Mawr277/RoboScribe/docs/Images/GUI2.png

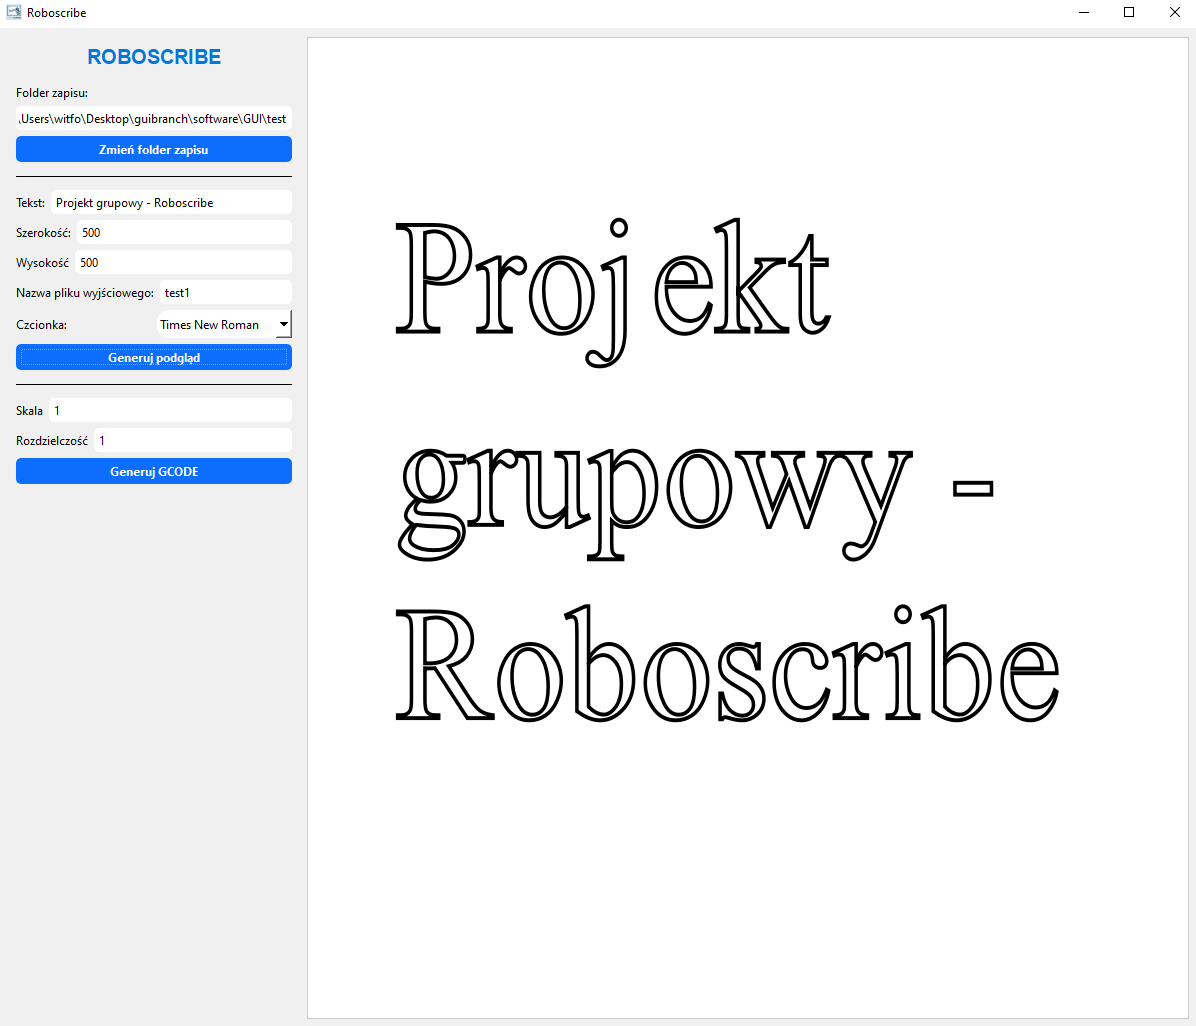
docs/Images/GUI2.png
