Mawr277/RoboScribe/docs/Images/GUI.png

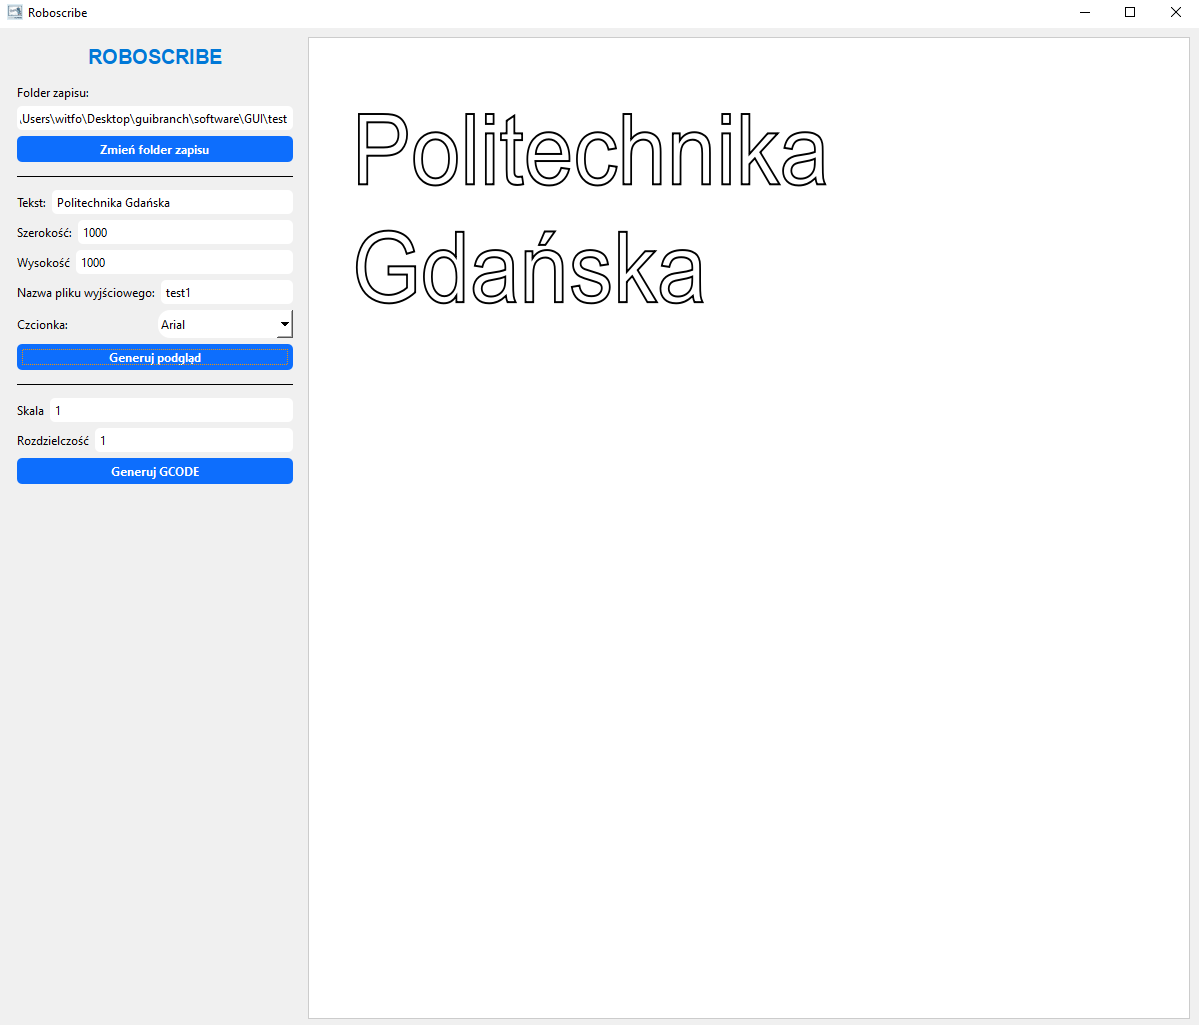
docs/Images/GUI.png
