Mawr277/RoboScribe/docs/Images/Schemat blokowy.png

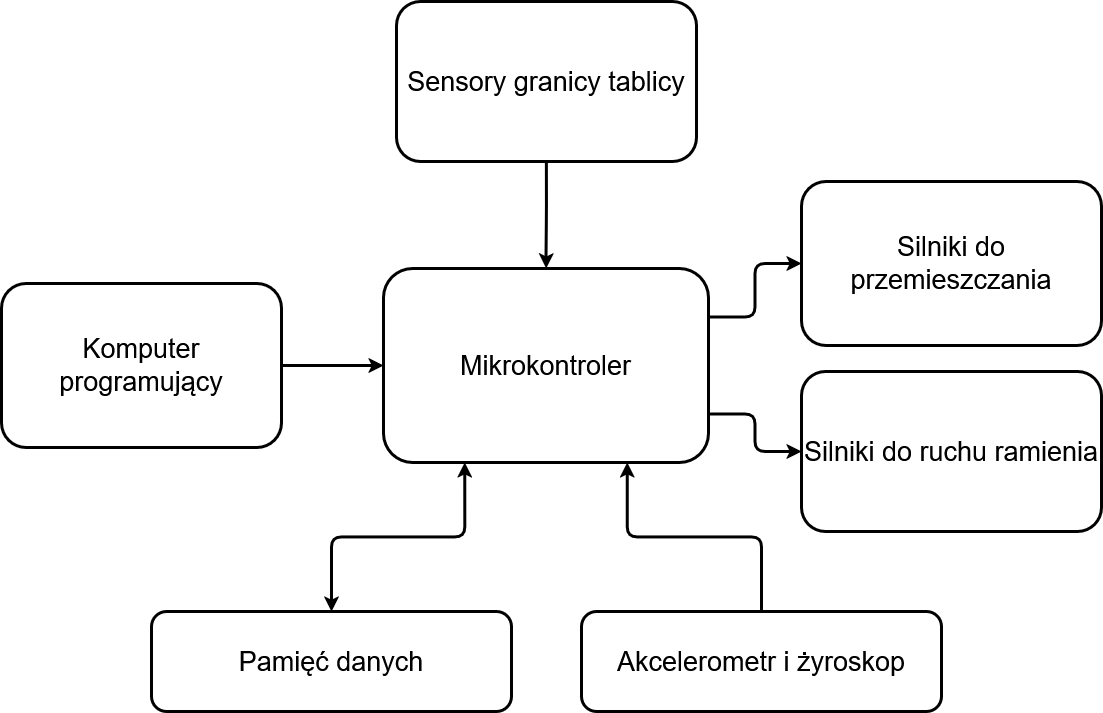
docs/Images/Schemat blokowy.png
