Mawr277/RoboScribe/docs/Images/Schemat funkcjonalny.png

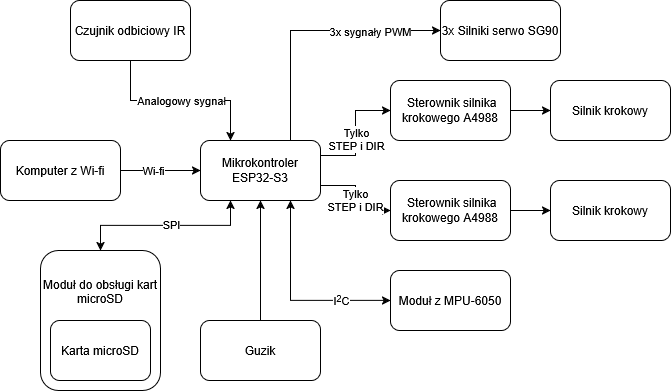
docs/Images/Schemat funkcjonalny.png
