Mawr277/RoboScribe/docs/Images/Zdjęcie modelu 3D.png

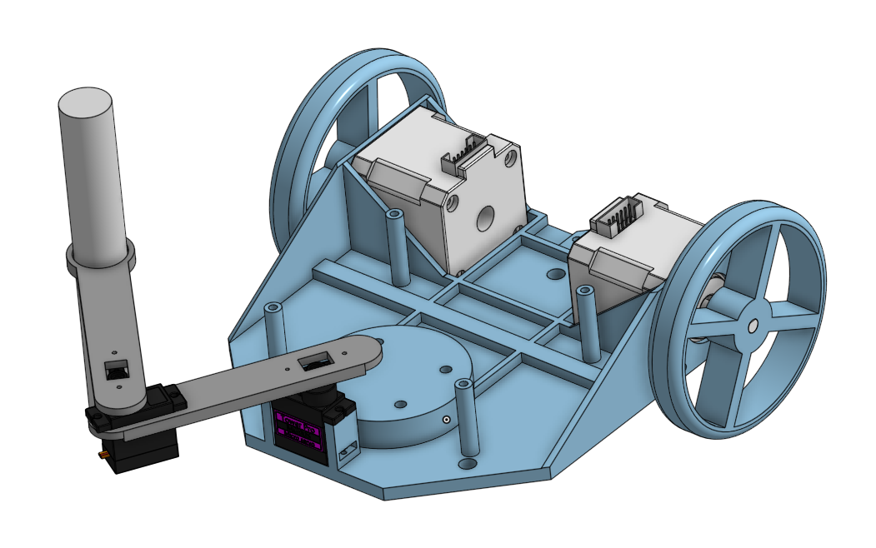
docs/Images/Zdjęcie modelu 3D.png
