Mawr277/RoboScribe/docs/circuit_schematic/schemat.kicad_pcb

## KiCad design Hardware/1_power.kicad_sch

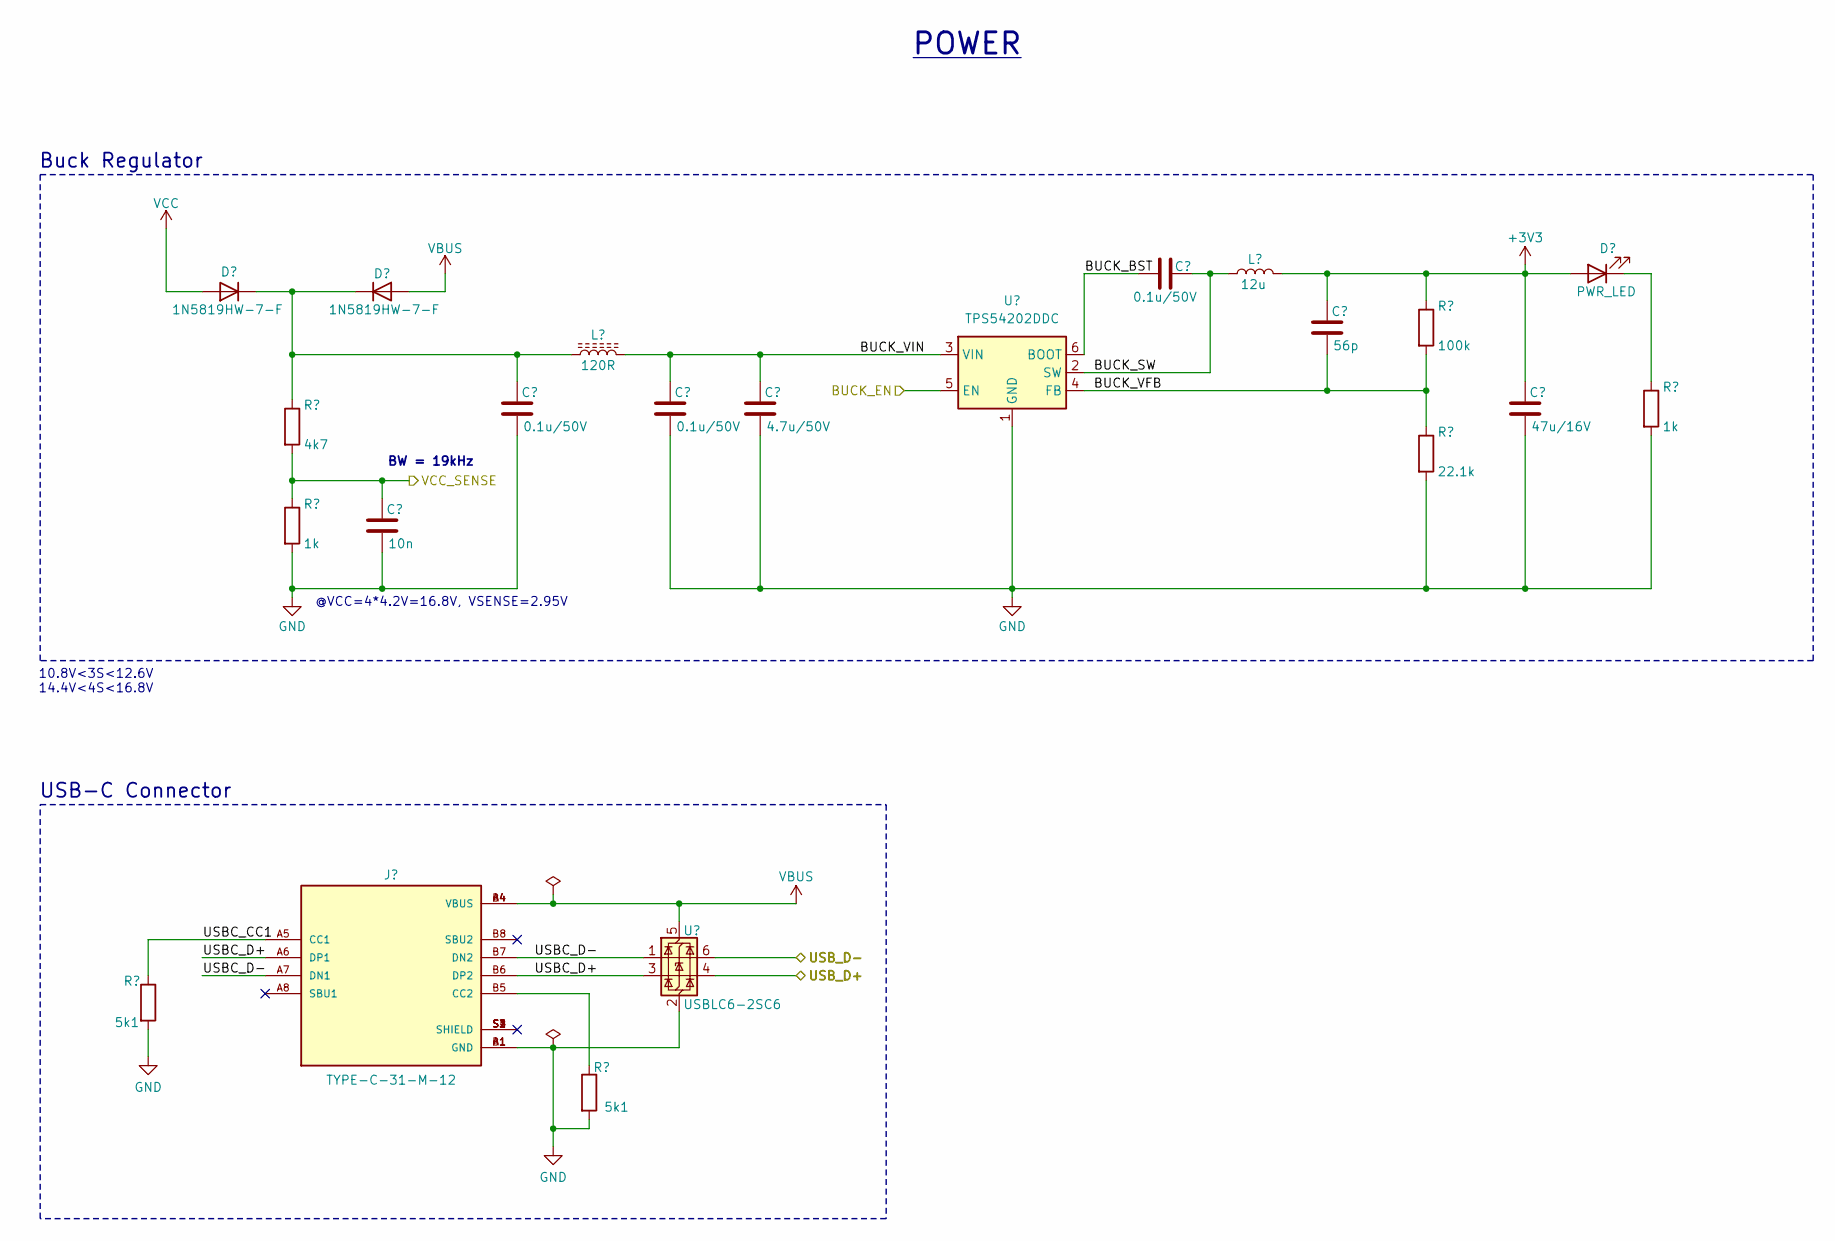
[picture p8: schematic 1_power.kicad_sch]

Parts:
J1: TYPE-C-31-M-12; HRO_TYPE-C-31-M-12; PARTREV 2020.12.08
U6: USBLC6-2SC6; SOT-23-6

Connections:
GND: J1.A1 (GND), J1.B1 (GND), U6.2 (GND)
unnamed: J1.S1 (SHIELD), J1.S2 (SHIELD), J1.S3 (SHIELD), J1.S4 (SHIELD)
USBC_CC1: J1.A5 (CC1)
USBC_D+: J1.A6 (DP1), J1.B6 (DP2), U6.3 (I/O2)
USBC_D-: J1.A7 (DN1), J1.B7 (DN2), U6.1 (I/O1)
USB_D+: U6.4 (I/O2)
USB_D-: U6.6 (I/O1)
VBUS: J1.A4 (VBUS), J1.B4 (VBUS), U6.5 (VBUS)

Notes on the sheet:
10.8V<3S<12.6V 14.4V<4S<16.8V
BW = 19kHz
USB-C Connector
POWER
@VCC=4*4.2V=16.8V, VSENSE=2.95V
Buck Regulator
