Mawr277/RoboScribe/(commit log)

2025-11-28 Adds MPU6050 drivers for communication and easy data acquisition
2025-11-28 Adds code for testing MPU6050 drivers functionality. Allows to check if chip is working properly
2025-12-29 Adds servo drivers for easier use
2025-12-29 Tests for servo drivers
2025-12-30 stworzenie plików
    [schemat.kicad_pcb, schemat.kicad_sch]
2025-12-30 wgranie diagramu połączeń
    [schemat.kicad_pcb, schemat.kicad_sch]
2025-12-31 przestawiony chemat
    [schemat.kicad_sch]
2026-01-04 Aktualna wersja schematu elektronicznego
    [schemat.kicad_sch]
2026-01-11 Add documentation for MPU6050 and servo drivers. Moves tests for drivers into their respective directories.
2026-01-12 Dodano rekursywne przetwarzanie grup elementów svg i prototypowa odwrotna kinematyka robota.
    Na tą chwile wszystkie ważne elementy svg są przetwarzane(poza Text ale to wynika głównie z ograniczeń biblioteki i trochę z samego formatu svg)
    Teoretycznie kod generuje gcode z kątami dla serwo ( komenta M1 T1= kąt dla pierszego T2 = kąt dla drugiego) oraz punkt dla bazy robota ale wymaga testów.
2026-01-14 working text to SVG generation
    added second button but SVG to GCODE function have hardcoded paths. Waiting for change of that
2026-01-14 working text to SVG generation button
    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
2026-01-18 Dodanie schematów blokowych oraz dodanie regulatora 5V do schematu
    [schemat.kicad_sch]
2026-01-19 Adds SDcard drivers that enable easy reading end writing with appropriate tests
2026-01-19 Changed circuit schematic directory to docs
    [schemat.kicad_pcb, schemat.kicad_sch]
2026-01-22 poprawki w gcode
    jeśli mamy ramię to nie da się zrobić stricte ze standardem chyba to robot będzie przeliczał kinematyke albo wymyślimy sobie kod G900 i powiemy że on robi to i to. Kwestią sporną może być komneda G1 Z1 oznacza ruch (pisak w dół) czy opisać to jakąś Mxx oznaczającą włączenie narzędzia
2026-01-23 update kinematyki odwrotnej
    zmiany:
    -kinematyka odwrotna
    dodano:
    - w testach jest program better który częściowo interpretuje gcode i robi animacje w matplotlib i zapisuje jako gif
2026-05-25 Basic implementation of stepper motors control consisting of initialization and functions to execute start/stop with chosen speed for selected motor
2026-05-25 Stepper motor basic movement driver implemented with recommended RMT espidf module with uniform encoder taken from espressif stepper motor example.
2026-05-25 Add blocking till movement is finished. Fix test parameters
    [main.c, stepper.c]
2026-06-02 SD card minor fixes. Add struct with servo parameters along with modified test
    [SDcard.c, SDcard.h, main.c, servo.c, servo.h]
2026-06-02 GCODE parser. Servo commands execution
2026-06-02 HTTP server for remote robot control through wifi. Contains: - Uploading, deleting files (UNTESTED: downloading) - Remote robot movement control - Reading data from accelerometer
    TODO: 1 Some structs should not belong here
    2 Data sending function probably should be
    more general
2026-06-03 Add HTTP server support for esp32
2026-06-06 Add timer-based polling for accelerometer data
2026-06-09 Add mutexes to variables modified by file_server and fix other periperals imports
    [SDcard.h, main.c]
2026-06-09 Create imu reading, file server and gcode execution task, synchronise variables access with mutexes. Attach default config files. Modify cmake.
